mike-rankin/ESP32-S3_Particle_CO2_Monitor/Images/Bare_Sensors.jpeg

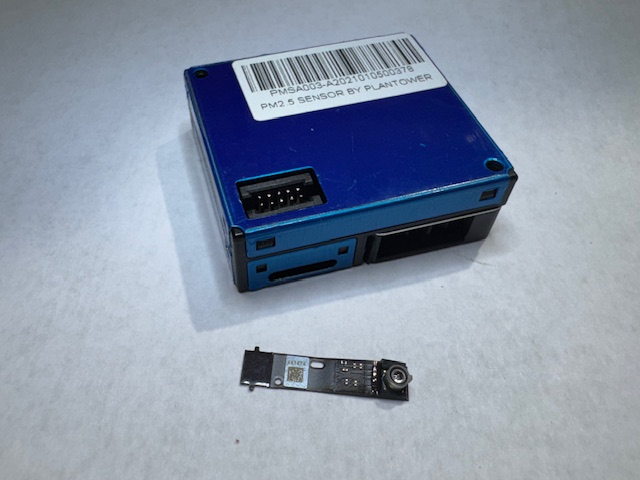
Images/Bare_Sensors.jpeg
