mike-rankin/ESP32-S3_Particle_CO2_Monitor/Images/Wall.jpeg

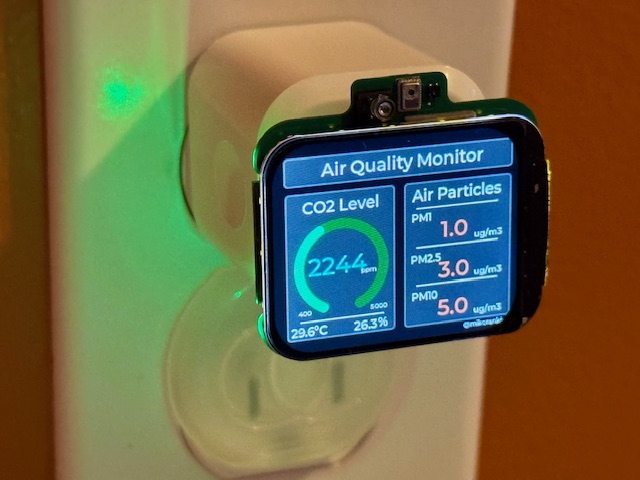
Images/Wall.jpeg
