mike-rankin/ESP32-S3_Particle_CO2_Monitor/PCB/Schematic_Rev2.pdf

VBUS | B4 VBUS | A9 GND B¹ GND A¹² | GND TAB² GND TAB¹

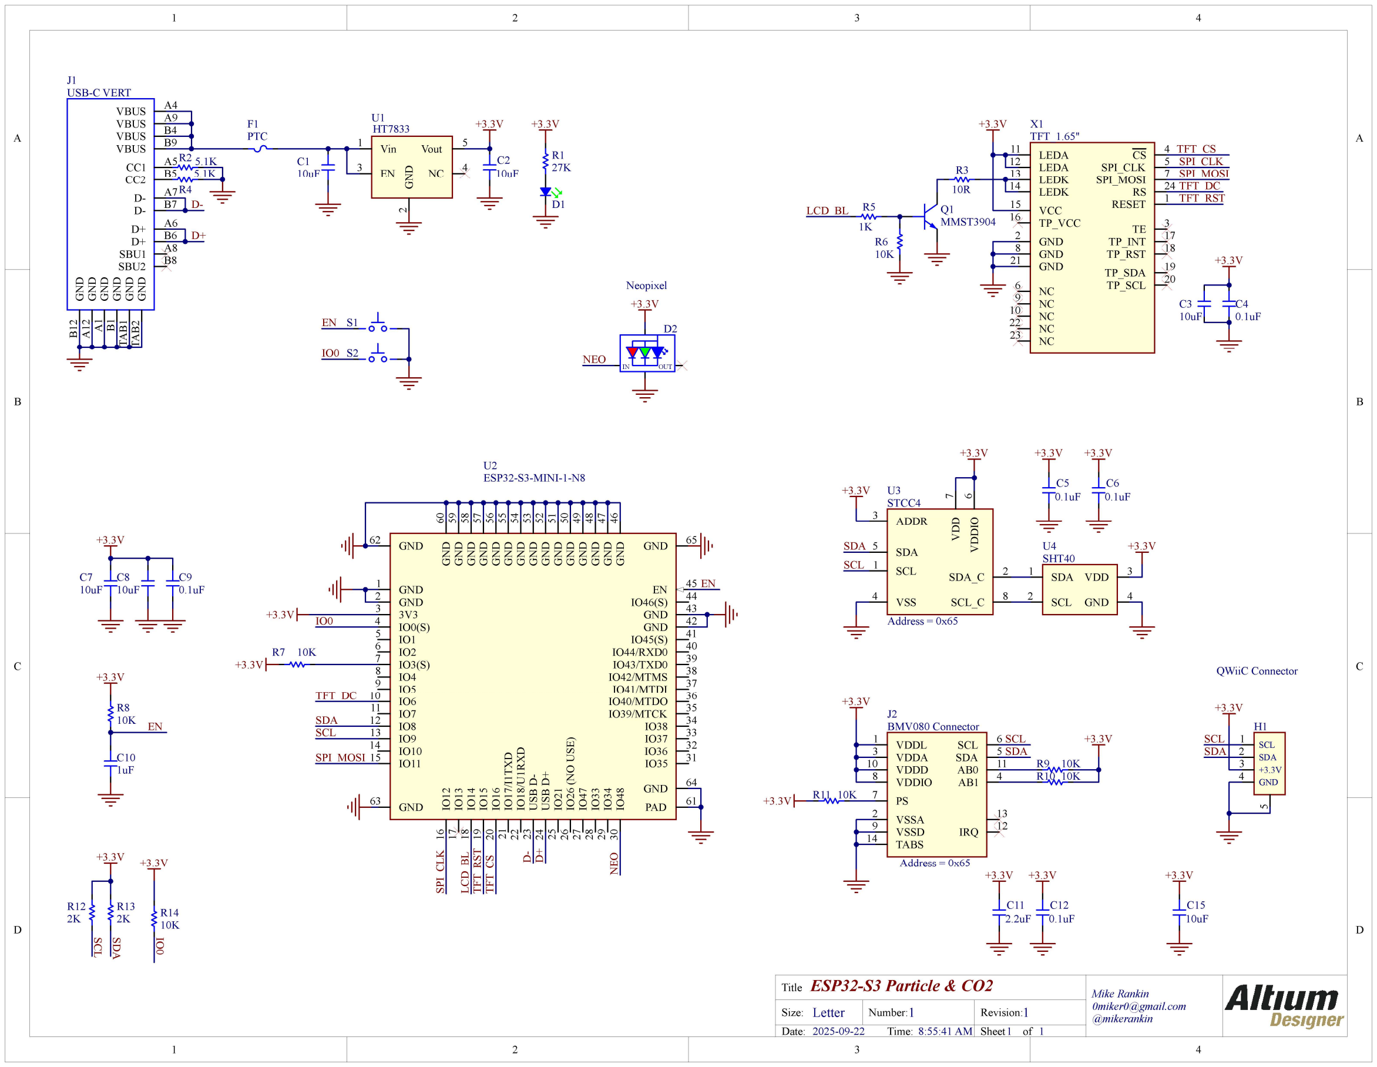
[picture p3: page 1]

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
Mike Rankin
0miker0@gmail.com
@mikerankin
1

## ESP32-S3 Particle & CO2

1 1
2025-09-22 | 8:55:41 AM

Title

Size: | Number:
Date:

Revision:
Time: | Sheet | of

Letter

LEDA 11

LEDK 13

GND 2

GND 21

NC 9

VCC 15

NC 10
NC 22
CS | 4
SPI_CLK | 5
SPI_MOSI | 7
RS | 24
RESET | 1
TE | 3

LEDA 12

LEDK 14

TP_VCC 16
TP_INT | 17
TP_RST | 18
TP_SDA | 19
TP_SCL | 20

GND 8

NC 23

NC 6

TFT_1.65"

X1

SPI_CLK
SPI_MOSI

TFT_CS

TFT_RST

TFT_DC

LCD_BL
MMST3904

Q1

+3.3V

+3.3V

0.1uF

C4
10uF

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
R2 5.1K
5.1K
R4

Vin 1

EN 3 | GND

2

Vout | 5
NC | 4

HT7833

U1

10uF

C2
10uF

C1

+3.3V

D1

27K

R1

+3.3V

S1

S2

EN GND A¹ GND B¹²

VBUS | A4
VBUS | B9

USB-C VERT

D+ | B6
SBU2 | B8
CC1 | A5
D- | B7
D+ | A6
D- | A7
SBU1 | A8
CC2 | B5

J1

IO0

Neopixel
+3.3V
IN | OUT

D2

NEO

+3.3V

SCL
SDA

QWiiC Connector

1
2
3

### 4 GND

+3.3V

SDA

## SCL5

H1

ESP32-S3-MINI-1-N8

GND 1
GND 2
3V3 3
IO0(S) 4
IO1 5
IO2 6
IO3(S) 7
IO4 8
IO5 9
IO6 10
IO7 11 | IO¹² 16 IO¹³ 17 IO¹⁴ 18 IO¹⁵ 19 IO¹⁶ 20 IO¹⁷/I1TXD 21 IO¹⁸/U¹RXD 22 USB D⁻ 23 USB D⁺ 24 IO²¹ 25 IO²⁶ ⁽NO USE⁾ 26 IO⁴⁷ 27
IO35 | 31 GND ⁴⁸ GND ⁴⁹ GND ⁵⁰ GND ⁵¹ GND ⁵² GND ⁵³ GND ⁵⁴ GND ⁵⁵ GND ⁵⁶ GND ⁵⁷ GND ⁵⁸ GND ⁵⁹ | IO³³ 28 GND ⁶⁰

GND 63

GND 62 | GND | 65
PAD | 61

IO8 12
IO9 13
IO10 14
IO11 15 | IO³⁴ 29 IO⁴⁸ 30
GND | 64
IO36 | 32 IO37 | 33 IO38 | 34 IO39/MTCK | 35 IO40/MTDO | 36 IO41/MTDI | 37 IO42/MTMS | 38 IO43/TXD0 | 39 IO44/RXD0 | 40 IO45(S) | 41 GND | 42 GND | 43 IO46(S) | 44 EN | 45 GND ⁴⁶ GND ⁴⁷

U2

+3.3V IO0

R7 10K
+3.3V
TFT_DC | TFT_RST | D⁻ D⁺

SDA
SCL | SPI_CLK | LCD_BL

SPI_MOSI

EN NEO TFT_CS

+3.3V

EN 10K

R8

1uF

C10

10uF

C8

2K

R12
2K

R13

# +3.3V SCL SDA

0.1uF

C9

+3.3V

10uF

C7

10K

R14 IO0

+3.3V

0.1uF

C5

SDA
SCL
+3.3V | +3.3V VDD

### 7 VDDIO

6
ADDR 3

SDA_C 2

SDA 5
SCL 1

VSS 4

Address = 0x65

SCL_C 8

STCC4

+3.3V U3

SHT40
SDA 1

GND 4

SCL 2

VDD 3

U4

0.1uF

C6

+3.3V

+3.3V

VDDL 1
VDDA 3

VDDIO 8

VDDD 10

PS 7
VSSA 2
VSSD 9
SCL | 6
SDA | 5
AB0 | 11
AB1 | 4
| 13
IRQ | 12
TABS 14

J2
BMV080 Connector

+3.3V

R11 10K +3.3V

SCL
SDA

+3.3V

R9 10K
R10 10K

+3.3V

2.2uF

C11
10uF

C15

+3.3V | +3.3V

0.1uF

C12

Address = 0x65
