mike-rankin/ESP32-S3_Particle_CO2_Monitor/Images/Backside.jpg

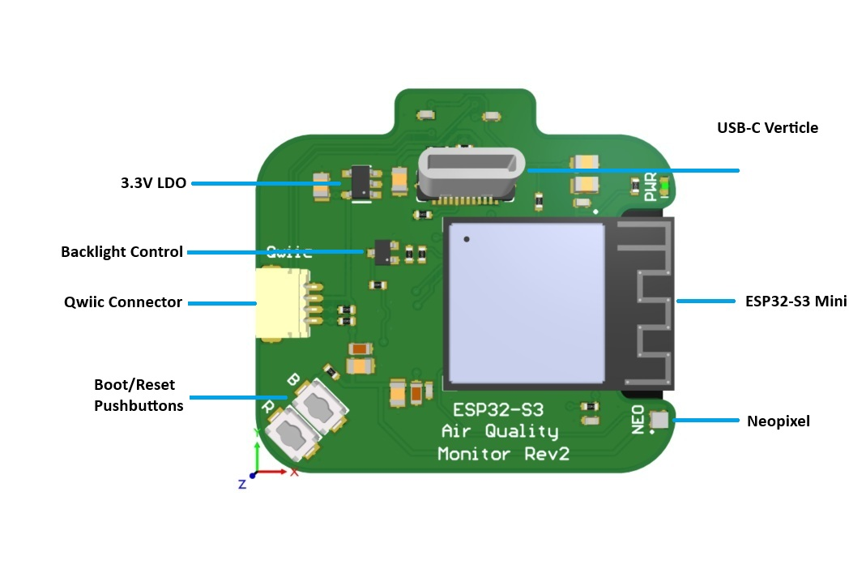
Images/Backside.jpg
