mike-rankin/ESP32-S3_Particle_CO2_Monitor/PCB/BOM_Rev2.xlsx

Designator | Quantity | Vendor | Part_Number | Description | Manufacturer | Value
C1, C2, C3, C7, C8, C15 | 6 |  |  | CAP 10uF 50V 0805, CAP 10uF 0805 |  | 10uF
C4 | 1 |  |  | CAP 0.1uF 0603 |  | 0.1uF
C5, C6, C9, C12 | 4 |  |  | CAP 0.1uF 0402 |  | 0.1uF
C10 | 1 |  |  | CAP 1uF 0402 |  | 1uF
C11 | 1 |  |  | CAP 2.2uF 0603 |  | 2.2uF
D1 | 1 | LCSC | C74338 | LED Green 0402 |  | Green Led
D2 | 1 | LCSC | C2909055 | LED,RGB,NEOPIXEL,SK6805-EC14 | OPSCO | NeoPixel
F1 | 1 | LCSC | C2982257 | PTC FUSE 0.5mA hold, 1A trip 0603 | JDT Fuse | PTC
H1 | 1 | LCSC | HC-1.0-4PWT-B-HW | CONN HEADER 4POS .100 R/A QWIIC | HCTL | QWiiC
J1 | 1 | Digi-Key | PLUG-USBC-241SMTV-4BQC15 | CONN RECPT USB-C Vertical w/TH Mount | GlobTek | USB-C VERT
J2 | 1 | Digi-Key | 5035661302 | CONN FFC BOTTOM 13POS 0.3MM R/A | Molex
Q1 | 1 | LCSC | C54879 | TRANSISTOR NPN GP 40V SC-70 | Changjiang | MMST3904
R1 | 1 |  |  | RES 27K 0402 |  | 27K
R2, R4 | 2 |  |  | RES 5.1K 0402 |  | 5.1K
R3 | 1 |  |  | RES 10R 0402 |  | 10R
R5 | 1 |  |  | RES 1K 0402 |  | 1K
R6, R7, R8, R9, R10, R11, R14 | 7 |  |  | RES 10K 0402 |  | 10K
R12, R13 | 2 |  |  | RES 2K 0402 |  | 2K
S1, S2 | 2 | Digi-Key | TL1015AF160QG | SWITCH MOMENTARY
U1 | 1 | LCSC | C164106 | IC LDO 3.3V 0.5A SOT23-5 | Holtek | HT7833
U2 | 1 | LCSC | C2913206 | WIFI/Bluetooth, 8M PSRAM, QFN-56 7x7 | Espressif | ESP32-S3-MINI-1-N8
U3 | 1 |  | STCC4 | CO2 SENSOR I2C SMD | Sensirion | STCC4
U4 | 1 | Digi-Key | SHT40-AD1B-R3 | Sensor Humidity/Temperature I2C SMD | Sensirion AG | SHT40
X1 | 1 | BuyDisplay | ER-TFT1.69-1 | 1.65 INCH TFT SPI GLASS Non Touch | BuyDisplay | TFT_1.65"
